prefac-raluca/Proiect-DCE/Aditional/Layout pdf/BOT.pdf

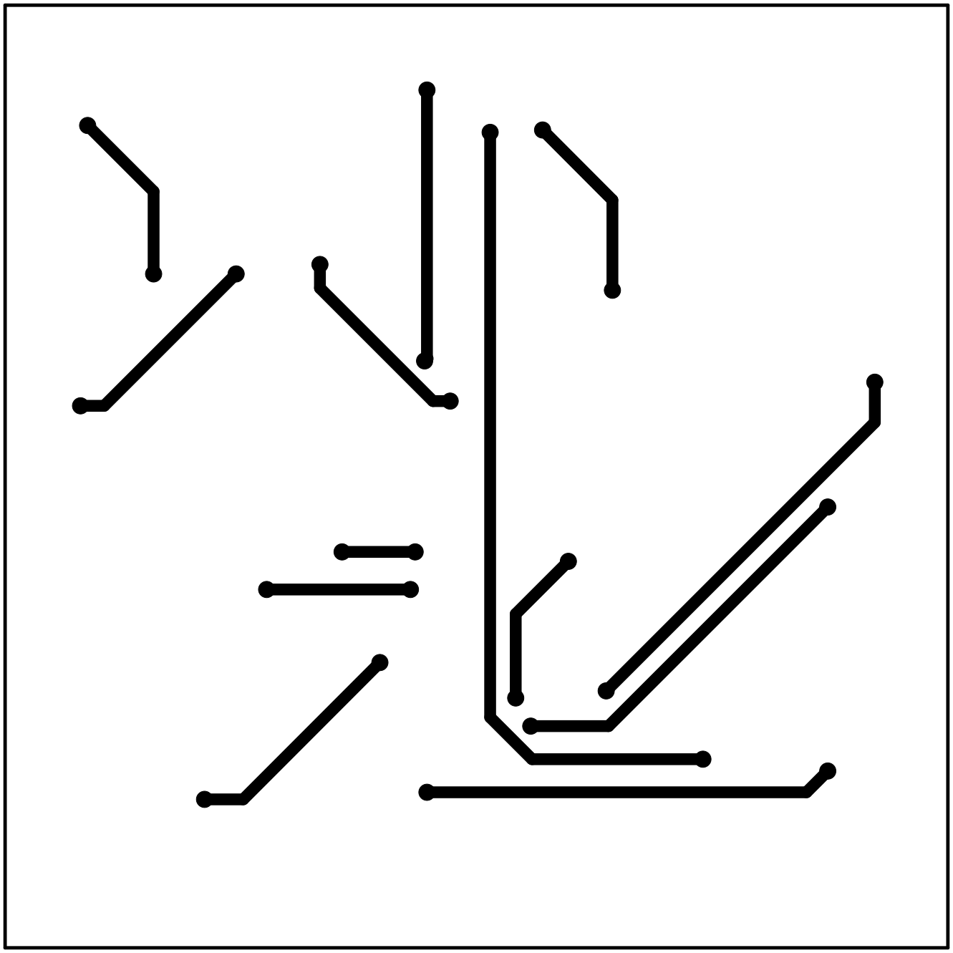
[picture p22: figure]
