prefac-raluca/Proiect-DCE/Aditional/Layout pdf/SMBOT.pdf

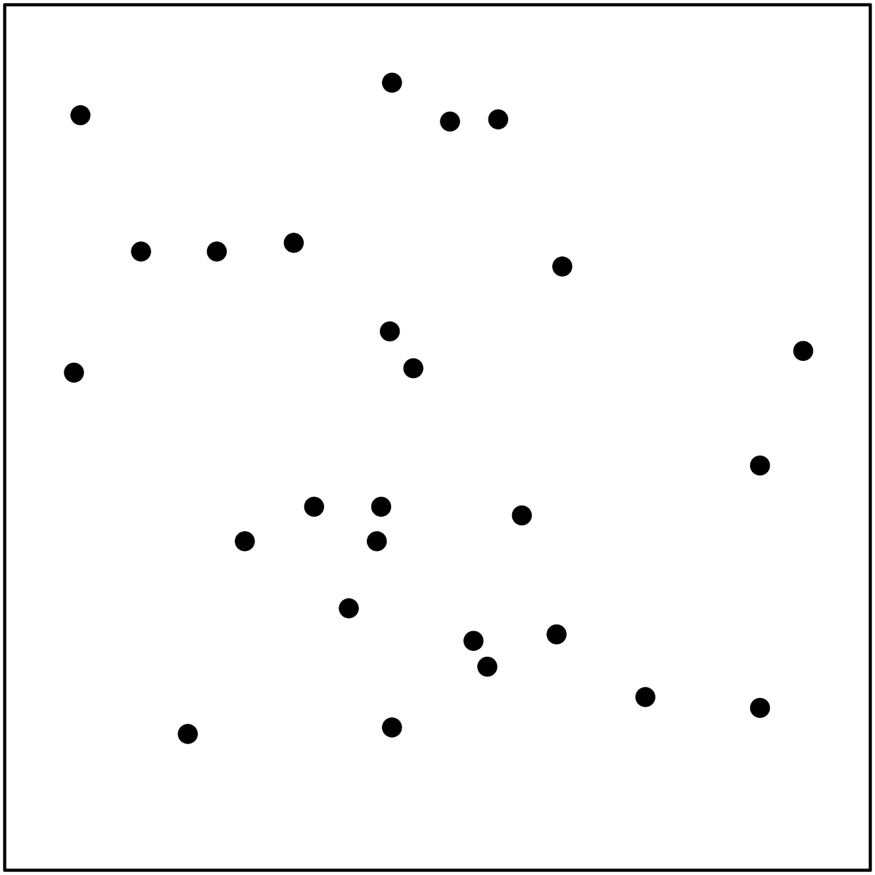
[picture p23: figure]
