prefac-raluca/Proiect-DCE/Aditional/Layout pdf/SMTOP.pdf

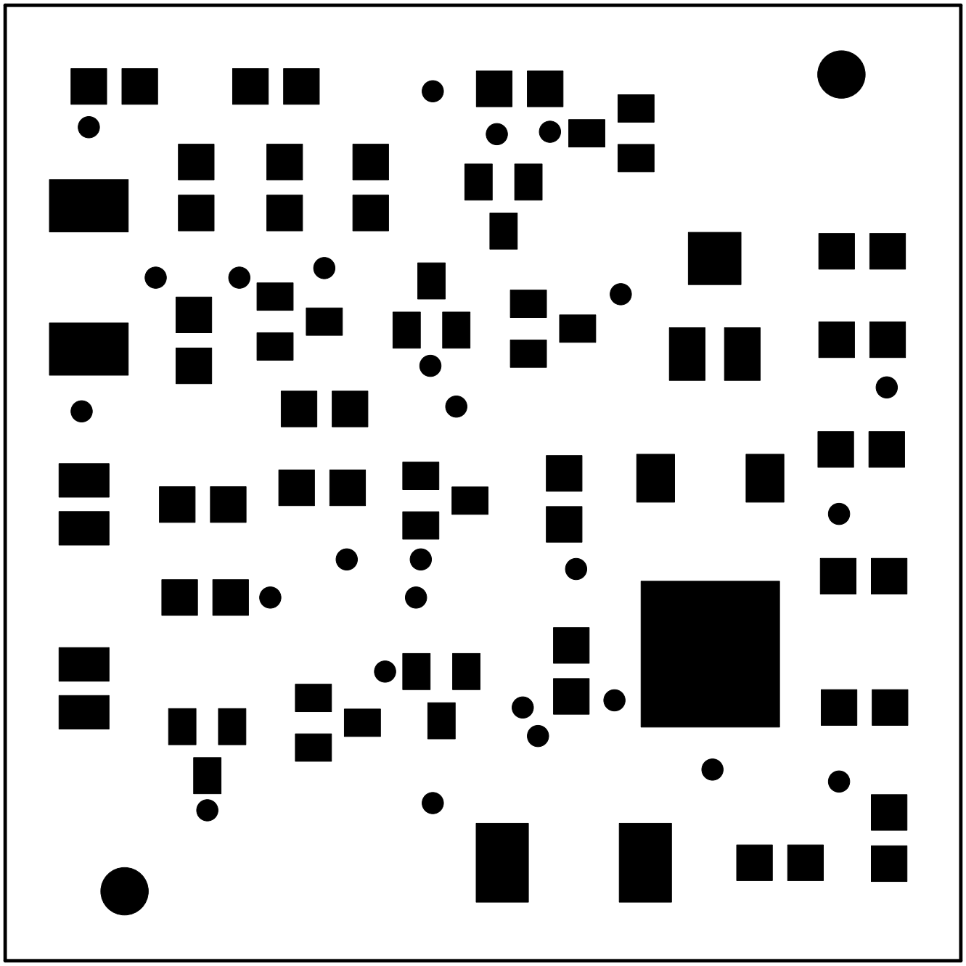
[picture p24: figure]
