prefac-raluca/Proiect-DCE/Aditional/ASAMBLARE/BOM_ASAMBLARE_Prefac Raluca_431C.pdf

Nr. Crt. | Nume | Catalog | Cod distrib | Nume prod | Prod | Clasă | Descriere | ALVEOLA | Nume componentă | Cantitate
1 | 0,47 | (LINK) (http://www.tme.eu/ro/details/smd0805-0r47/rezistente-smd-0805/royal-ohm/0805s8j047kt5e/) | SMD0805-0R47 | 0805S8J047 KT5E | ROYAL OHM | rezistor | Rezistor SMD, chip, 0805, 0.47Ω, ±5%, 0.125W | 1a | R10 | 1
2 | 1 | (LINK) (https://www.tme.eu/ro/details/smd0805-1r/rezistente-smd-0805/royal-ohm/0805s8j010jt5e/) | SMD0805-1R-5% | 0805S8J010 JT5E | ROYAL OHM | rezistor | Rezistor SMD, chip, 0805, 1Ω, ±5%, 0.125W | 1b | R11 | 1
3 | 33 | (LINK) (https://www.tme.eu/ro/details/smd0805-33r/rezistente-smd-0805/royal-ohm/0805s8j0330t5e/) | SMD0805-33R-5% | 0805S8J033 0T5E | ROYAL OHM | rezistor | Rezistor SMD, chip, 0805, 33Ω, ±5%, 0.125W | 3b | R16 | 1
4 | 51 | (LINK) (http://www.tme.eu/ro/details/rc0805jr-0751r/rezistente-smd-0805/yageo/rc0805jr-0751rl/) | SMD0805-51R-5% | 0805S8J051 0T5E | ROYAL OHM | rezistor | Rezistor SMD, chip, 0805, 51Ω, ±5%, 0.125W | 4a | R4, R5, R6 | 3
5 | 100 | (LINK) (https://www.tme.eu/ro/details/smd0805-100r/rezistente-smd-0805/royal-ohm/0805s8j0101t5e/) | SMD0805-100R-5% | 0805S8J010 1T5E | ROYAL OHM | rezistor | Rezistor SMD, chip, 0805, 100Ω, ±5%, 0.125W | 5b | R17 | 1
6 | 150 | (LINK) (https://www.tme.eu/ro/details/smd0805-150r/rezistente-smd-0805/royal-ohm/0805s8j0151t5e/) | SMD0805-150R-5% | 0805S8F150 0T5E | ROYAL OHM | rezistor | Rezistor SMD, chip, 0805, 150Ω, ±5%, 0.125W | 6a | R8,R9,R18,R19 | 4
7 | 510 | (LINK) (https://www.tme.eu/ro/details/smd0805-510r/rezistente-smd-0805/royal-ohm/0805s8j0511t5e/) | SMD0805-510R-5% | 0805S8J051 1T5E | YAGEO | rezistor | Rezistor SMD, chip, 0805, 510Ω, ±5%, 0.125W | 8a | R2, R3, R13 | 3
8 | 1k | (LINK) (https://www.tme.eu/ro/details/smd0805-1k/rezistente-smd-0805/royal-ohm/0805s8j0102t5e/) | SMD0805-1K-5% | 0805S8J010 2T5E | ROYAL OHM | rezistor | Rezistor SMD, chip, 0805, 1kΩ, ±5%, 0.125W | 10a | R7 | 1
9 | 2k | (LINK) (https://www.tme.eu/ro/details/smd0805-2k/rezistente-smd-0805/royal-ohm/0805s8j0202t5e/) | SMD0805-2K-5% | 0805S8J020 2T5E | ROYAL OHM | rezistor | Rezistor SMD, chip, 0805, 2kΩ, ±5%, 0.125W | 11b | R12 | 1
10 | 3.3k | (LINK) (https://www.tme.eu/ro/details/smd0805-3k3/rezistente-smd-0805/royal-ohm/0805s8j0332t5e/) | SMD0805-3K3-5% | 0805S8J033 2T5E | ROYAL OHM | rezistor | Rezistor SMD, chip, 0805, 3.3kΩ, ±5%, 0.125W | 13a | R1, R15 | 2
11 | 2k | (LINK) (https://www.tme.eu/ro/details/ts53yl2k/trimere-smd-cu-o-singura-tura/vishay/ts53yl202mr10/) | TS53YL202 MR10 | TS53YL202 MR10 | VISHAY | potențiometr u | Potențiome-tru liniar, simplă tură, SMD, 2kΩ, ±20%, 100ppm/°C, 0.25W | 25b | R14 | 1

## Anexa a1 - Prefac Raluca - Grupa 431C - Tema SERS

| TOTAL - Componente pasive (rezistoare de valori fixe şi reglabile) | 19
12 | 1uF | (LINK) (https://www.tme.eu/ro/details/cl21b105kbfnnng/condensatoare-mlcc-smd-0805/samsung/) | CL21B105K BFNNNG | CL21B105K BFNNNG | SAMSUNG | condensator | Condensator: ceramic; MLCC; 1uF; 50V; X7R; ±20%; SMD; 0805 | 36a | C1, C2 | 2
| TOTAL - Componente pasive (condensatoare) | | | | | | | | | 2
13 | 4148 | (LINK) (http://www.tme.eu/ro/details/1n4148-0805/diode-universale-smd/dc-components/cd4148ws0805c/) | 1N4148-0805 | CD4148WS( 0805C) | Components DC | diodă pn | Diodă comutație, SMD, 0805, 300mA, 100V | 37b | D2, D3 | 2
14 | 2.7V | (LINK) (https://www.tme.eu/ro/details/bzx84-c2v7.215/diode-zener-smd/nexperia/bzx84-c2v7-215/) | BZX84C2V7 | BZX84-C2V7LT1G | ON Semiconduct or | diodă Zener | Diodă Zener, SMD, SOT23, 2,7V, ±5%, 0.25W | 38b | D1 | 1
15 | PNP | (LINK) (http://www.tme.eu/ro/details/bc856b-dio/tranzistori-smd-pnp/diotec-semiconductor/bc856b/) | BC856B | BC856B | DIOTEC | tranzistor bipolar | Tranzistor bipolar PNP, SMD, SOT23, 80V, 100mA | 41b | Q1, Q2 | 2
16 | NPN | (LINK) (https://www.tme.eu/ro/details/bc846b-dio/tranzistori-smd-npn/diotec-semiconductor/bc846b/) | BC846B | BC846B | DIOTEC | tranzistor bipolar | Tranzistor bipolar NPN, SMD, SOT23, 65V, 100mA | 42a | Q3,Q4,Q5,Q7,Q8,Q9 | 6
17 | NPN | (LINK) (http://www.tme.eu/ro/details/mjd31cg/tranzistori-smd-npn/on-semiconductor/) | MJD31CG | MJD31CG | ON Semiconduct or | tranzistor bipolar | Tranzistor bipolar NPN, SMD, DPACK, 100V, 3A, 15W | 44b | Q6 | 1
| TOTAL - Componente semiconductoare (tranzistoare bipolare şi cu efect de câmp, diode, LED, etc.) | | | | | | | | | 12
| Total general | | | | | | | | | 33
