prefac-raluca/Proiect-DCE/Aditional/ASAMBLARE/Repartizare BOM_2023-2024 1.pdf

Nr. Crt. | Nume | Catalog | Cod distrib | Nume prod | Prod | Clasă | Descriere | Alveola
1 | 0 ohm | (LINK) (http://www.tme.eu/ro/details/smd1206-0r/rezistente-smd-1206/royal-ohm/1206s4j0000t5e/) | 1206S4J000 0T5E | 1206S4J000 0T5E | SR PASSIVES | rezistor | Rezistor: thick film; SMD; 1206; 0Ω; 0,25W; ±5%; -55÷125°C | x
2 | 0.47 | (LINK) (http://www.tme.eu/ro/details/smd0805-0r47/rezistente-smd-0805/royal-ohm/0805s8j047kt5e/) | SMD0805-0R47 | 0805S8J047 KT5E | ROYAL OHM | rezistor | Rezistor SMD, chip, 0805, 0.47Ω, ±5%, 0.125W | 1a
3 | 1 | (LINK) (http://www.tme.eu/ro/details/smd0805-1r-1%25/rezistente-smd-0805/royal-ohm/0805s8f100kt5e/) | SMD0805-1R-1% | 0805S8F100 KT5E | ROYAL OHM | rezistor | Rezistor SMD, chip, 0805, 1Ω, ±1%, 0.125W | 1b
4 | 4.7 | (LINK) (http://www.tme.eu/ro/details/smd0805-4r7-1%25/rezistente-smd-0805/royal-ohm/0805waf-4r7-t5e/) | SMD0805-4R7-1% | 0805WAF 4R7 T5E | ROYAL OHM | rezistor | Rezistor SMD, chip, 0805, 4.7Ω, ±1%, 0.125W | 2a
5 | 10 | (LINK) (http://www.tme.eu/ro/details/smd0805-10r-1%25/rezistente-smd-0805/royal-ohm/0805s8f100jt5e/) | SMD0805-10R-1% | 0805S8F100 JT5E | ROYAL OHM | rezistor | Rezistor SMD, chip, 0805, 10Ω, ±1%, 0.125W | 2b
6 | 22 | (LINK) (http://www.tme.eu/ro/details/smd0805-22r-1%25/rezistente-smd-0805/royal-ohm/0805s8f220jt5e/) | SMD0805-22R-1% | 0805S8F220 JT5E | ROYAL OHM | rezistor | Rezistor SMD, chip, 0805, 22Ω, ±1%, 0.125W | 3a
7 | 33 | (LINK) (http://www.tme.eu/ro/details/smd0805-33r-1%25/rezistente-smd-0805/royal-ohm/0805s8f330jt5e/) | SMD0805-33R-1% | 0805S8F330 JT5E | ROYAL OHM | rezistor | Rezistor SMD, chip, 0805, 33Ω, ±1%, 0.125W | 3b
8 | 51 | (LINK) (http://www.tme.eu/ro/details/rc0805jr-0751r/rezistente-smd-0805/yageo/rc0805jr-0751rl/) | SMD0805-51R-1% | 0805S8F510 JT5E | ROYAL OHM | rezistor | Rezistor SMD, chip, 0805, 51Ω, ±1%, 0.125W | 4a
9 | 68 | (LINK) (http://www.tme.eu/ro/details/smd0805-68r-1%25/rezistente-smd-0805/royal-ohm/0805s8f680jt5e/) | SMD0805-68R-1% | 0805S8F680 JT5E | ROYAL OHM | rezistor | Rezistor SMD, chip, 0805, 68Ω, ±1%, 0.125W | 4b
10 | 82 | (LINK) (http://www.tme.eu/ro/details/smd0805-82r-1%25/rezistente-smd-0805/royal-ohm/0805s8f820jt5e/) | SMD0805-82R-1% | 0805S8F820 JT5E | ROYAL OHM | rezistor | Rezistor SMD, chip, 0805, 82Ω, ±1%, 0.125W | 5a
11 | 100 | (LINK) (http://www.tme.eu/ro/details/smd0805-100r-1%25/rezistente-smd-0805/royal-ohm/0805s8f1000t5e/) | SMD0805-100R-1% | 0805S8F100 0T5E | ROYAL OHM | rezistor | Rezistor SMD, chip, 0805, 100Ω, ±1%, 0.125W | 5b
12 | 150 | (LINK) (http://www.tme.eu/ro/details/smd0805-150r-1%25/rezistente-smd-0805/royal-ohm/0805s8f1500t5e/) | SMD0805-150R-1% | 0805S8F150 0T5E | ROYAL OHM | rezistor | Rezistor SMD, chip, 0805, 150Ω, ±1%, 0.125W | 6a

Anexa 1 - BOM total anul al III-lea - 2018-2019

13 | 220 | (LINK) (http://www.tme.eu/ro/details/smd0805-220r-1%25/rezistente-smd-0805/royal-ohm/0805s8f2200t5e/) | SMD0805-220R-1% | 0805S8F220 0T5E | ROYAL OHM | rezistor | Rezistor SMD, chip, 0805, 220Ω, ±1%, 0.125W | 6b
14 | 330 | (LINK) (http://www.tme.eu/ro/details/smd0805-330r-1%25/rezistente-smd-0805/royal-ohm/0805s8f3300t5e/) | SMD0805-330R-1% | 0805S8F330 0T5E | ROYAL OHM | rezistor | Rezistor SMD, chip, 0805, 330Ω, ±1%, 0.125W | 7a
15 | 470 | (LINK) (http://www.tme.eu/ro/details/smd0805-470r-1%25/rezistente-smd-0805/royal-ohm/0805s8f4700t5e/) | SMD0805-470R-1% | 0805S8F470 0T5E | ROYAL OHM | rezistor | Rezistor SMD, chip, 0805, 470Ω, ±1%, 0.125W | 7b
16 | 510 | (LINK) (http://www.tme.eu/ro/details/smd0805-510r/rezistente-smd-0805/royal-ohm/0805s8j0511t5e/) | SMD0805-510R-5% | 0805S8J051 1T5E | ROYAL OHM | rezistor | Rezistor SMD, chip, 0805, 510Ω, ±5%, 0.125W | 8a
17 | 680 | (LINK) (http://www.tme.eu/ro/details/smd0805-680r-1%25/rezistente-smd-0805/royal-ohm/0805s8f6800t5e/) | SMD0805-680R-1% | 0805S8F680 0T5E | ROYAL OHM | rezistor | Rezistor SMD, chip, 0805, 680Ω, ±1%, 0.125W | 8b
18 | 820 | (LINK) (http://www.tme.eu/ro/details/smd0805-820r-1%25/rezistente-smd-0805/royal-ohm/0805s8f8200t5e/) | SMD0805-820R-1% | 0805S8F820 0T5E | ROYAL OHM | rezistor | Rezistor SMD, chip, 0805, 820Ω, ±1%, 0.125W | 9a
19 | 910 | (LINK) (http://www.tme.eu/ro/details/smd0805-910r/rezistente-smd-0805/royal-ohm/0805waj-910r-t5e/) | SMD0805-910R-5% | 0805WAJ 910R T5E | ROYAL OHM | rezistor | Rezistor SMD, chip, 0805, 910Ω, ±5%, 0.125W | 9b
20 | 1k | (LINK) (http://www.tme.eu/ro/details/smd0805-1k-1%25/rezistente-smd-0805/royal-ohm/0805s8f1001t5e/) | SMD0805-1K-1% | 0805S8F100 1T5E | ROYAL OHM | rezistor | Rezistor SMD, chip, 0805, 1kΩ, ±1%, 0.125W | 10a
21 | 1.5k | (LINK) (http://www.tme.eu/ro/details/smd0805-1k5-1%25/rezistente-smd-0805/royal-ohm/0805s8f1501t5e/) | SMD0805-1K5-1% | 0805S8F150 1T5E | ROYAL OHM | rezistor | Rezistor SMD, chip, 0805, 1.5kΩ, ±1%, 0.125W | 10b
22 | 1.8k | (LINK) (http://www.tme.eu/ro/details/smd0805-1k8-1%25/rezistente-smd-0805/royal-ohm/0805s8f1801t5e/) | SMD0805-1K8-1% | 0805S8F180 1T5E | ROYAL OHM | rezistor | Rezistor SMD, chip, 0805, 1.8kΩ, ±1%, 0.125W | 11a
23 | 2k | (LINK) (http://www.tme.eu/ro/details/smd0805-2k-1%25/rezistente-smd-0805/royal-ohm/0805s8f2001t5e/) | SMD0805-2K-1% | 0805S8F200 1T5E | ROYAL OHM | rezistor | Rezistor SMD, chip, 0805, 2kΩ, ±1%, 0.125W | 11b
24 | 2.2k | (LINK) (http://www.tme.eu/ro/details/smd0805-2k2-1%25/rezistente-smd-0805/royal-ohm/0805s8f2201t5e/) | SMD0805-2K2-1% | 0805S8F220 1T5E | ROYAL OHM | rezistor | Rezistor SMD, chip, 0805, 2.2kΩ, ±1%, 0.125W | 12a
25 | 2.7k | (LINK) (http://www.tme.eu/ro/details/smd0805-2k7-1%25/rezistente-smd-0805/royal-ohm/0805s8f2701t5e/) | SMD0805-2K7-1% | 0805S8F270 1T5E | ROYAL OHM | rezistor | Rezistor SMD, chip, 0805, 2.7kΩ, ±1%, 0.125W | 12b

26 | 3.3k | (LINK) (http://www.tme.eu/ro/details/smd0805-3k3-1%25/rezistente-smd-0805/royal-ohm/0805s8f3301t5e/) | SMD0805-3K3-1% | 0805S8F330 1T5E | ROYAL OHM | rezistor | Rezistor SMD, chip, 0805, 3.3kΩ, ±1%, 0.125W | 13a
27 | 3.9k | (LINK) (http://www.tme.eu/ro/details/smd0805-3k9-1%25/rezistente-smd-0805/royal-ohm/0805s8f3901t5e/) | SMD0805-3K9-1% | 0805S8F390 1T5E | ROYAL OHM | rezistor | Rezistor SMD, chip, 0805, 3.9kΩ, ±1%, 0.125W | 13b
28 | 4.7k | (LINK) (http://www.tme.eu/ro/details/smd0805-4k7-1%25/rezistente-smd-0805/royal-ohm/0805s8f4701t5e/) | SMD0805-4K7-1% | 0805S8F470 1T5E | ROYAL OHM | rezistor | Rezistor SMD, chip, 0805, 4.7kΩ, ±1%, 0.125W | 14a
29 | 5.6k | (LINK) (http://www.tme.eu/ro/details/smd0805-5k6-1%25/rezistente-smd-0805/royal-ohm/0805s8f5601t5e/) | SMD0805-5K6-1% | 0805S8F560 1T5E | ROYAL OHM | rezistor | Rezistor SMD, chip, 0805, 5.6kΩ, ±1%, 0.125W | 14b
30 | 6.8k | (LINK) (http://www.tme.eu/ro/details/smd0805-6k8-1%25/rezistente-smd-0805/royal-ohm/0805s8f6801t5e/) | SMD0805-6K8-1% | 0805S8F680 1T5E | ROYAL OHM | rezistor | Rezistor SMD, chip, 0805, 6.8kΩ, ±1%, 0.125W | 15a
31 | 8.2k | (LINK) (http://www.tme.eu/ro/details/smd0805-8k2-1%25/rezistente-smd-0805/royal-ohm/0805s8f8201t5e/) | SMD0805-8K2-1% | 0805S8F820 1T5E | ROYAL OHM | rezistor | Rezistor SMD, chip, 0805, 8.2kΩ, ±1%, 0.125W | 15b
32 | 9.1k | (LINK) (http://www.tme.eu/ro/details/smd0805-9k1-1%25/rezistente-smd-0805/royal-ohm/0805waf-9k1-t5e/) | SMD0805-9K1-1% | CRCW08051 0K0FKTABC | VISHAY | rezistor | Rezistor SMD, chip, 0805, 9.1kΩ, ±1%, 0.125W | 16a
33 | 10k | (LINK) (http://www.tme.eu/ro/details/crcw080510k0fktabc/rezistente-smd-0805/vishay/) | SMD0805-10K-1% | 0805S8F100 2T5E | ROYAL OHM | rezistor | Rezistor SMD, chip, 0805, 10kΩ, ±1%, 0.125W | 16b
34 | 15k | (LINK) (http://www.tme.eu/ro/details/smd0805-15k-1%25/rezistente-smd-0805/royal-ohm/0805s8f1502t5e/) | SMD0805-15K-1% | 0805S8F150 2T5E | ROYAL OHM | rezistor | Rezistor SMD, chip, 0805, 15kΩ, ±1%, 0.125W | 17a
35 | 22k | (LINK) (http://www.tme.eu/ro/details/smd0805-22k-1%25/rezistente-smd-0805/royal-ohm/0805s8f2202t5e/) | SMD0805-22K-1% | 0805S8F220 2T5E | ROYAL OHM | rezistor | Rezistor SMD, chip, 0805, 22kΩ, ±1%, 0.125W | 17b
36 | 47k | (LINK) (http://www.tme.eu/ro/details/smd0805-47k/rezistente-smd-0805/royal-ohm/0805s8j0473t5e/) | 0805S8J047 3T5E | 0805S8J047 3T5E | ROYAL OHM | rezistor | Rezistor: thick film; SMD; 0805; 47kΩ; 0,125W; ±5%; -55÷125°C | 18a
37 | 68k | (LINK) (http://www.tme.eu/ro/details/rc0805jr-0768k/rezistente-smd-0805/yageo/rc0805jr-0768kl/) | SMD0805-68K-5% | RC0805JR-0768KL | Yageo | rezistor | Rezistor SMD, chip, 0805, 68kΩ, ±5%, 0.125W | 18b

38 | 100k | (LINK) (http://www.tme.eu/ro/details/smd0805-100k-1%25/rezistente-smd-0805/royal-ohm/0805s8f1003t5e/) | SMD0805-100K-1% | 0805S8F100 3T5E | ROYAL OHM | rezistor | Rezistor SMD, chip, 0805, 100kΩ, ±1%, 0.125W | 19a
39 | 150k | (LINK) (http://www.tme.eu/ro/details/smd0805-150k/rezistente-smd-0805/royal-ohm/0805s8j0154t5e/) | SMD0805-150K-5% | 0805S8J015 4T5E | ROYAL OHM | rezistor | Rezistor SMD, chip, 0805, 150kΩ, ±5%, 0.125W | 19b
40 | 180k | (LINK) (http://www.tme.eu/ro/details/smd0805-180k/rezistente-smd-0805/royal-ohm/0805s8j0184t5e/) | SMD0805-180K-5% | 0805S8J018 4T5E | ROYAL OHM | rezistor | Rezistor SMD, chip, 0805, 180kΩ, ±5%, 0.125W | 20a
41 | 220k | (LINK) (http://www.tme.eu/ro/details/smd0805-220k-1%25/rezistente-smd-0805/royal-ohm/0805s8f2203t5e/) | SMD0805-220K-1% | 0805S8F220 3T5E | ROYAL OHM | rezistor | Rezistor SMD, chip, 0805, 220kΩ, ±1%, 0.125W | 20b
42 | 330k | (LINK) (http://www.tme.eu/ro/details/smd0805-330k-1%25/rezistente-smd-0805/royal-ohm/0805s8f3303t5e/) | SMD0805-330K-1% | 0805S8F330 3T5E | ROYAL OHM | rezistor | Rezistor SMD, chip, 0805, 330kΩ, ±1%, 0.125W | 21a
43 | 390k | (LINK) (http://www.tme.eu/ro/details/smd0805-390k-1%25/rezistente-smd-0805/royal-ohm/0805s8f3903t5e/) | SMD0805-390K-1% | 0805S8F390 3T5E | ROYAL OHM | rezistor | Rezistor SMD, chip, 0805, 390kΩ, ±1%, 0.125W | 21b
44 | 510k | (LINK) (http://www.tme.eu/ro/details/smd0805-510k-1%25/rezistente-smd-0805/royal-ohm/0805s8f5103t5e/) | SMD0805-510K-1% | 0805S8F510 3T5E | ROYAL OHM | rezistor | Rezistor SMD, chip, 0805, 510kΩ, ±1%, 0.125W | 22a
45 | 1M | (LINK) (http://www.tme.eu/ro/details/smd0805-1m/rezistente-smd-0805/royal-ohm/0805s8j0105t5e/) | SMD0805-1M | 0805S8J010 5T5E | ROYAL OHM | rezistor | Rezistor SMD, chip, 0805, 1MΩ, ±1%, 0.125W | 22b
46 | 2M | (LINK) (http://www.tme.eu/ro/details/smd0805-2m/rezistente-smd-0805/royal-ohm/0805waj-2m-t5e/) | SMD0805-2M7 | 0805WAJ 2M T5E | ROYAL OHM | rezistor | Rezistor SMD, chip, 0805, 2MΩ, ±1%, 0.125W | 23a
47 | 5M | (LINK) (http://www.tme.eu/ro/details/smd0805-5m1/rezistente-smd-0805/royal-ohm/0805s8j0515t5e/) | SMD0805-5M1 | RC0805FR-075M1 | Yageo | rezistor | Rezistor SMD, chip, 0805, 5.1MΩ, ±1%, 0.125W | 23b
48 | 10M | (LINK) (http://www.tme.eu/ro/details/hp05-10m5%25/rezistente-smd-0805/royal-ohm/hp05w3j0106t5e/) | SMD0805-10M | HP05W3J01 06T5E | ROYAL OHM | rezistor | Rezistor SMD, chip, 0805, 10MΩ, ±5%, 0.125W | 24a

49 | 100ohm | (LINK) (http://www.tme.eu/ro/details/1804gsmd-100r/trimere-smd-cu-o-singura-tura/sr-passives/) | 1804GSMD-100R | 1804GSMD-100R | SR PASSIVES | potențiometr u | Potențiome-tru liniar, simplă tură, SMD, 100Ω, ±10%, 100ppm/°C, 0.25W | 24b
50 | 500ohm | (LINK) (http://www.tme.eu/ro/details/1804gsmd-500r/trimere-smd-cu-o-singura-tura/sr-passives/) | 1804GSMD-500R | 1804GSMD-500R | SR PASSIVES | potențiometr u | Potențiome-tru liniar, simplă tură, SMD, 500Ω, ±10%, 100ppm/°C, 0.25W | 25a
51 | 2k | (LINK) (http://www.tme.eu/ro/details/ts53yl2k/trimere-smd-cu-o-singura-tura/vishay/ts53yl202mr10/) | TS53YL202 MR10 | TS53YL202 MR10 | VISHAY | potențiometr u | Potențiome-tru liniar, simplă tură, SMD, 2kΩ, ±20%, 100ppm/°C, 0.25W | 25b
52 | 5k | (LINK) (http://www.tme.eu/ro/details/3314g-1-502e/trimere-smd-cu-o-singura-tura/bourns/) | 3314G-1-502E | 3314G-1-502E | BOURNS | potențiometr u | Potențiome-tru liniar, simplă tură, SMD, 5kΩ, ±20%, 100ppm/°C, 0.25W | 26a
53 | 10k | (LINK) (http://www.tme.eu/ro/details/3314g-1-103e/trimere-smd-cu-o-singura-tura/bourns/) | 3314G-1-103E | 3314G-1-103E | BOURNS | potențiometr u | Potențiome-tru liniar, simplă tură, SMD, 10kΩ, ±20%, 100ppm/°C, 0.25W | 26b
54 | 50k | (LINK) (http://www.tme.eu/ro/details/3314g-1-503e/trimere-smd-cu-o-singura-tura/bourns/) | 3314G-1-503E | 3314G-1-503E | BOURNS | potențiometr u | Potențiome-tru liniar, simplă tură, SMD, 50kΩ, ±20%, 100ppm/°C, 0.25W | 27a
55 | 100k | (LINK) (http://www.tme.eu/ro/details/ts53yl100k/trimere-smd-cu-o-singura-tura/vishay/ts53yl104mr10/) | TS53YL104 MR10 | TS53YL104 MR10 | VISHAY | potențiometr u | Potențiome-tru liniar, simplă tură, SMD, 100kΩ, ±20%, 100ppm/°C, 0.25W | 27b
56 | 500k | (LINK) (http://www.tme.eu/ro/details/3314g-1-504e/trimere-smd-cu-o-singura-tura/bourns/) | 3314G-1-504E | 3314G-1-504E | BOURNS | potențiometr u | Potențiome-tru liniar, simplă tură, SMD, 500kΩ, ±10%, 100ppm/°C, 0.25W | 28a
57 | 4.7pF | (LINK) (http://www.tme.eu/ro/details/cc0805crnpo94r7/condensatoare-mlcc-smd-0805/yageo/cc0805crnpo9bn4r7/) | CC0805CRN PO9BN4R7 | CC0805CRN PO9BN4R7 | YAGEO | condensator | ceramic; MLCC; 4,7pF; 50V; C0G; ±0,25pF; SMD; 0805 | 28b
58 | 10pF | (LINK) (http://www.tme.eu/ro/details/cc0805jrnpo9100/condensatoare-mlcc-smd-0805/yageo/cc0805jrnpo9bn100/) | CC0805JRN PO9BN100 | CC0805JRN PO9BN100 | YAGEO | condensator | ceramic; MLCC; 10pF; 50V; C0G; ±5%; SMD; 0805 | 29a

59 | 47pF | (LINK) (http://www.tme.eu/ro/details/cl21c470jbannnc/condensatoare-mlcc-smd-0805/samsung/) | CL21C470JB ANNNC | CL21C470JB ANNNC | SAMSUNG | condensator | Condensator : ceramic; MLCC; 47pF; 50V; C0G; ±5%; SMD; 0805; -55÷125°C | 29b
60 | 100pF | (LINK) (http://www.tme.eu/ro/details/cl21c101jbannnc/condensatoare-mlcc-smd-0805/samsung/) | CL21C101JB ANNNC | CL21C101JB ANNNC | SAMSUNG | condensator | Condensator : ceramic; MLCC; 100pF; 50V; C0G; ±5%; SMD; 0805 | 30a
61 | 470pF | (LINK) (http://www.tme.eu/ro/details/cl10b471kb8nnnc/condensatoare-mlcc-smd-0603/samsung/) | CL10B471K B8NNNC | CL10B471K B8NNNC | SAMSUNG | condensator | Condensator : ceramic; MLCC; 470pF; 50V; X7R; ±10%; SMD; 0603 | 30b
62 | 1nF | (LINK) (http://www.tme.eu/ro/details/c0805c102j5gac/condensatoare-mlcc-smd-0805/kemet/) | C0805C102J 5GAC | C0805C102J 5GAC | KEMET | condensator | Condensator MLCC, SMD, 0805, 1nF, ±5%, 50V, C0G | 31a
63 | 2.2nF | (LINK) (http://www.tme.eu/ro/details/cl21b222kbannnd/condensatoare-mlcc-smd-0805/samsung/) | CL21B222K BANNND | CL21B222K BANNND | SAMSUNG | condensator | Condensator : ceramic; MLCC; 2,2nF; 50V; X7R; ±10%; SMD; 0805 | 31b
64 | 4.7nF | (LINK) (http://www.tme.eu/ro/details/c0805c472k5rac/condensatoare-mlcc-smd-0805/kemet/) | C0805C472 K5RAC | C0805C472 K5RAC | KEMET | condensator | Condensator MLCC, SMD, 0805, 4.7nF, ±5%, 50V, X7R | 32a
65 | 5.6nF | (LINK) (http://www.tme.eu/ro/details/cl21b562kbannnc/condensatoare-mlcc-smd-0805/samsung/) | CL21B562K BANNNC | CL21B562K BANNNC | SAMSUNG | condensator | Condensator MLCC, SMD, 0805, 5.6nF, ±5%, 50V, X7R | 32b
66 | 10nF | (LINK) (http://www.tme.eu/ro/details/cl21b103kcannnc/condensatoare-mlcc-smd-0805/samsung/) | CL21B103K CANNNC | CL21B103K CANNNC | SAMSUNG | condensator | Condensator MLCC, SMD, 0805, 10nF, ±5%, 50V, X7R | 33a
67 | 22nF | (LINK) (http://www.tme.eu/ro/details/cl21b223kcfnnne/condensatoare-mlcc-smd-0805/samsung/) | CL21B223K CFNNNE | CL21B223K CFNNNE | SAMSUNG | condensator | Condensator : ceramic; MLCC; 22nF; 100V; X7R; ±10%; SMD; 0805 | 33b
68 | 33nF | (LINK) (http://www.tme.eu/ro/details/cl21b333kbannnc/condensatoare-mlcc-smd-0805/samsung/) | CL21B333K BANNNC | CL21B333K BANNNC | SAMSUNG | condensator | Condensator : ceramic; MLCC; 33nF; 50V; X7R; ±10%; SMD; 0805 | 34a
69 | 100nF | (LINK) (http://www.tme.eu/ro/details/cc0805krx7r9104/condensatoare-mlcc-smd-0805/yageo/cc0805krx7r9bb104/) | CC0805KRX 7R9BB104 | CC0805KRX 7R9BB104 | YAGEO | condensator | ceramic; MLCC; 100nF; 50V; X7R; ±10%; SMD; 0805 | 34b

70 | 220nF | (LINK) (http://www.tme.eu/ro/details/cl21b224kafnnne/condensatoare-mlcc-smd-0805/samsung/) | CL21B224K AFNNNE | CL21B224K AFNNNE | SAMSUNG | condensator | Condensator : ceramic; MLCC; 220nF; 25V; X7R; ±10%; SMD; 0805 | 35a
71 | 330nF | (LINK) (http://www.tme.eu/ro/details/08055c334kat2a/condensatoare-mlcc-smd-0805/avx/) | 08055C334K AT2A | 08055C334K AT2A | AVX | condensator | Condensator : ceramic; MLCC; 330nF; 50V; X7R; ±10%; SMD; 0805 | x
72 | 470nF | (LINK) (http://www.tme.eu/ro/details/cl21b474kbfnnng/condensatoare-mlcc-smd-0805/samsung/) | CL21B474K BFNNNG | CL21B474K BFNNNG | SAMSUNG | condensator | Condensator : ceramic; MLCC; 470nF; 50V; Y5V; -20÷+80%; SMD; 0805 | 35b
73 | 1uF | (LINK) (http://www.tme.eu/ro/details/cc0805kkx7r8105/condensatoare-mlcc-smd-0805/yageo/cc0805kkx7r8bb105/) | CC0805KKX 7R8BB105 | CC0805KKX 7R8BB105 | YAGEO | condensator | Condensator : ceramic; MLCC; 1uF; 25V; X7R; ±10%; SMD; 0805 | 36a
74 | 2.2uF | (LINK) (http://www.tme.eu/ro/details/grm219r61e225ka12d/condensatoare-mlcc-smd-0805/murata/) | GRM219R61 E225KA12D | GRM219R61 E225KA12D | MURATA | condensator | Condensator : ceramic; MLCC; 2,2uF; 25V; X5R; ±10%; SMD; 0805 | 36b
75 | 4.7uF | (LINK) (http://www.tme.eu/ro/details/cl21a475kaqnnne/condensatoare-mlcc-smd-0805/samsung/) | CL21A475K AQNNNE | CL21A475K AQNNNE | SAMSUNG | condensator | ceramic; MLCC; 4,7uF; 25V; X5R; ±10%; SMD; 0805 | 37a
76 | 10uF | (LINK) (http://www.tme.eu/ro/details/eeefk1j100p/condensatoare-electrol-smd-imped-joasa/panasonic/) | SC1H106M0 5005VR | SC1H106M0 5005VR | SAMWHA | condensator | Condensator : electrolitic; cu impedanţă redusă; SMD; 10uF; 63V | x
| TOTAL - Componente pasive (condensatoare)
77 | 4148 | (LINK) (http://www.tme.eu/ro/details/1n4148-0805/diode-universale-smd/dc-components/cd4148ws0805c/) | 1N4148-0805 | CD4148WS( 0805C) | DC Components | diodă pn | Diodă comutație, SMD, 0805, 300mA, 100V | 37b
78 | LED | (LINK) (http://www.tme.eu/ro/details/kp-2012src-prv/led-uri-smd-0805/kingbright-electronic/) | KP-2012SRC-PRV | KP-2012SRC-PRV | Kingbright Electronic | LED | LED roșu, SMD, 0805, 100mcd, 640nm, 120° | 38a
79 | 2.7V | (LINK) (http://www.tme.eu/ro/details/bzx84c2v7/diode-zener-smd/on-semiconductor/bzx84c2v7lt1g/) | BZX84C2V7 | BZX84-C2V7LT1G | ON Semiconduct or | diodă Zener | Diodă Zener, SMD, SOT23, 2,7V, ±5%, 0.25W | 38b
80 | 5.1V | (LINK) (http://www.tme.eu/ro/details/bzx84c5v1/diode-zener-smd/nxp/bzx84-c5v1215/) | BZX84C5V1 | BZX84-C5V1 | NXP | diodă Zener | Diodă Zener, SMD, SOT23, 5,1V, ±5%, 0.3W | 39a

81 | 5.6V | (LINK) (http://www.tme.eu/ro/details/bzx84c5v6/diode-zener-smd/nxp/bzx84-c5v6215/) | BZX84C5V6 | BZX84-C5V6 | NXP | diodă Zener | Diodă Zener, SMD, SOT23, 5,6V, ±5%, 0.3W | 39b
82 | 6.2V | (LINK) (http://www.tme.eu/ro/details/bzx84c6v2/diode-zener-smd/nxp/bzx84-c6v2215/) | BZX84C6V2 | BZX84-C6V2 | NXP | diodă Zener | Diodă Zener, SMD, SOT23, 6.2V, ±5%, 0.3W | 40a
83 | 6.8V | (LINK) (http://www.tme.eu/ro/details/bzx84c6v8/diode-zener-smd/nxp/bzx84-c6v8215/) | BZX84C6V8 | BZX84-C6V8 | NXP | diodă Zener | Diodă Zener, SMD, SOT23, 6.8V, ±5%, 0.3W | x
84 | 8.2V | (LINK) (http://www.tme.eu/ro/details/bzx84c8v2/diode-zener-smd/nxp/bzx84-c8v2215/) | BZX84C8V2 | BZX84-C8V2 | NXP | diodă Zener | Diodă Zener, SMD, SOT23, 8.2V, ±5%, 0.3W | 40b
85 | 10V | (LINK) (http://www.tme.eu/ro/details/bzx84c10/diode-zener-smd/nxp/bzx84-c10215/) | BZX84C10 | BZX84-C10 | NXP | diodă Zener | Diodă Zener, SMD, SOT23, 10V, ±5%, 0.3W | 41a
86 | PNP | (LINK) (http://www.tme.eu/ro/details/bc856b-dio/tranzistori-smd-pnp/diotec-semiconductor/bc856b/) | BC856B | BC856B | DIOTEC | tranzistor bipolar | Tranzistor bipolar PNP, SMD, SOT23, 80V, 100mA | 41b
87 | NPN | (LINK) (http://www.tme.eu/ro/details/bc846b.215/tranzistori-smd-npn/nxp/) | BC846B | BC846B | NXP | tranzistor bipolar | Tranzistor bipolar NPN, SMD, SOT23, 65V, 100mA | 42a
89 | N-JFET | (LINK) (http://www.tme.eu/ro/details/mmbfj309lt1g/tranzistori-canal-n-smd/on-semiconductor/) | MMBFJ309L T1G | MMBFJ309L T1G | ON Semiconduct or | tranzistor NJFET | Tranzistor N-JFET, SMD, SOT23, 25V, 30mA | 42b
90 | P-JFET | (LINK) (http://www.tme.eu/ro/details/mmbfj177lt1g/tranzistori-canal-p-smd/on-semiconductor/) | MMBFJ177L T1G | MMBFJ177L T1G | ON Semiconduct or | tranzistor PJFET | Tranzistor P-JFET, SMD, SOT23, 30V, 20mA | 43a
91 | NPN | (LINK) (http://www.tme.eu/ro/details/bc817-25-dio/tranzistori-smd-npn/diotec-semiconductor/bc817-25/) | BC817-25-DIO | BC817-25-DIO | NXP | tranzistor bipolar | Tranzistor bipolar NPN, SMD, SOT23, 45V, 800mA | 43b
93 | PNP | (LINK) (http://www.tme.eu/ro/details/bc807-25-dio/tranzistori-smd-pnp/diotec-semiconductor/bc807-25/) | BC807-25-DIO | BC807-25-DIO | NXP | tranzistor bipolar | Tranzistor bipolar PNP, SMD, SOT23, 45V, 800mA | 44a
94 | NPN | (LINK) (http://www.tme.eu/ro/details/mjd31cg/tranzistori-smd-npn/on-semiconductor/) | MJD31CG | MJD31CG | ON Semiconduct or | tranzistor bipolar | Tranzistor bipolar NPN, SMD, DPACK, 100V, 3A, 15W | 44b

96 | PNP | (LINK) (http://www.tme.eu/ro/details/mjd32cg/tranzistori-smd-pnp/on-semiconductor/) | MJD32CG | MJD32CG | ON Semiconduct or | tranzistor bipolar | Tranzistor bipolar PNP, SMD, DPACK, 100V, 3A, 15W | 45a
97 | Nmos | (LINK) (http://www.tme.eu/ro/details/irfr120npbf/tranzistori-canal-n-smd/international-rectifier/) | IRFR120NP BF | IRFR120NP BF | International Rectifier | tranzistor NMOS | Tranzistor N-MOSFET, SMD, DPAK, 100V, 9.1A, 20V, 39W | 45b
| TOTAL - Componente semiconductoare (tranzistoare bipolare şi cu efect de câmp, diode, LED, etc.)
98 | Conn2p | (LINK) (http://www.tme.eu/ro/details/zl301-40p/pini-cu-benzi-si-soclu/ninigi/) | ZL301-40P | ZL301-40P | NINIGI | Sir pini, pas 2,54mm, SMD | Sir pini, pas 2,54mm, SMD, tip tata, bareta de 40 pini | x
99 | FUSE | (LINK) (http://www.tme.eu/ro/details/3413.0116.11/sigurante-smd-1206-ultrarapide/schurter/) | 3413.0116.1 1 | 3413.0116.1 1 | SCHURTER | sigu-ranță | Siguranță sticlă, SMD, 1206, 1.25A, 48mΩ | x
| Total - Conectică, sigurante fuzibile, etc.
| Total general
