prefac-raluca/Proiect-DCE/Proiect_Schematic.pdf

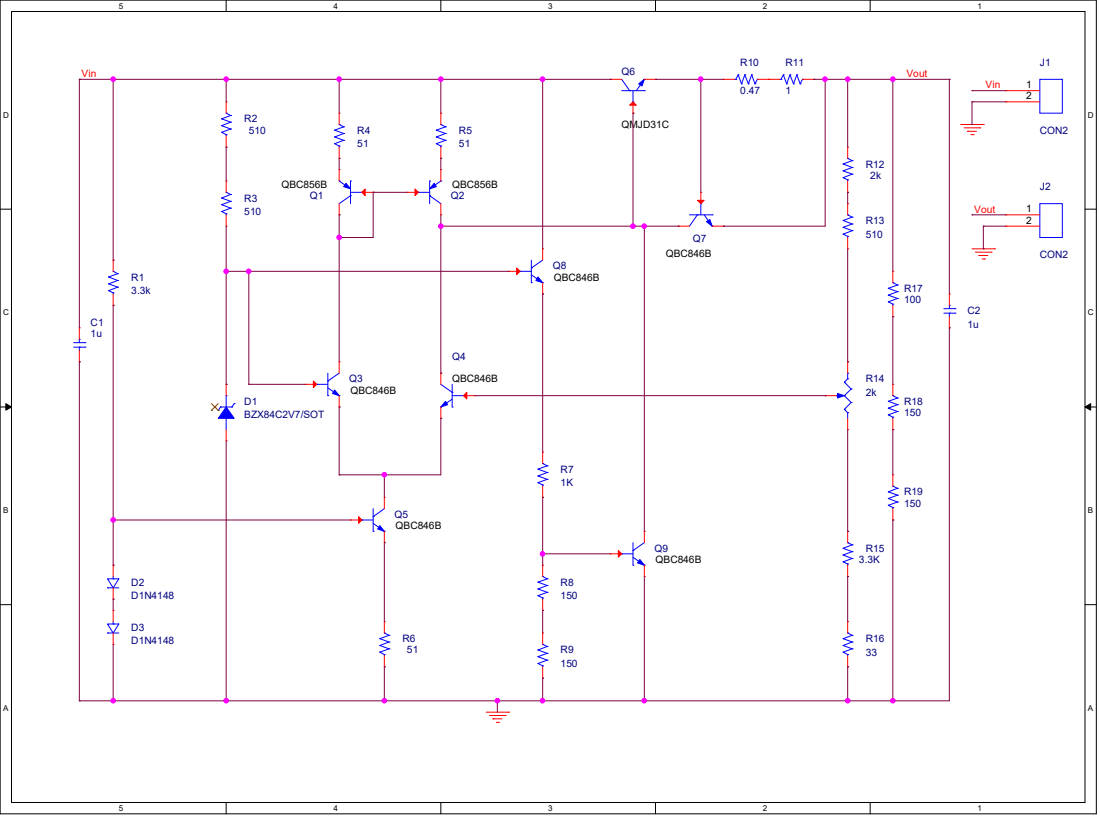
[picture p25: page 1]
