prefac-raluca/Proiect-DCE/Aditional/ASAMBLARE/ALL.pdf

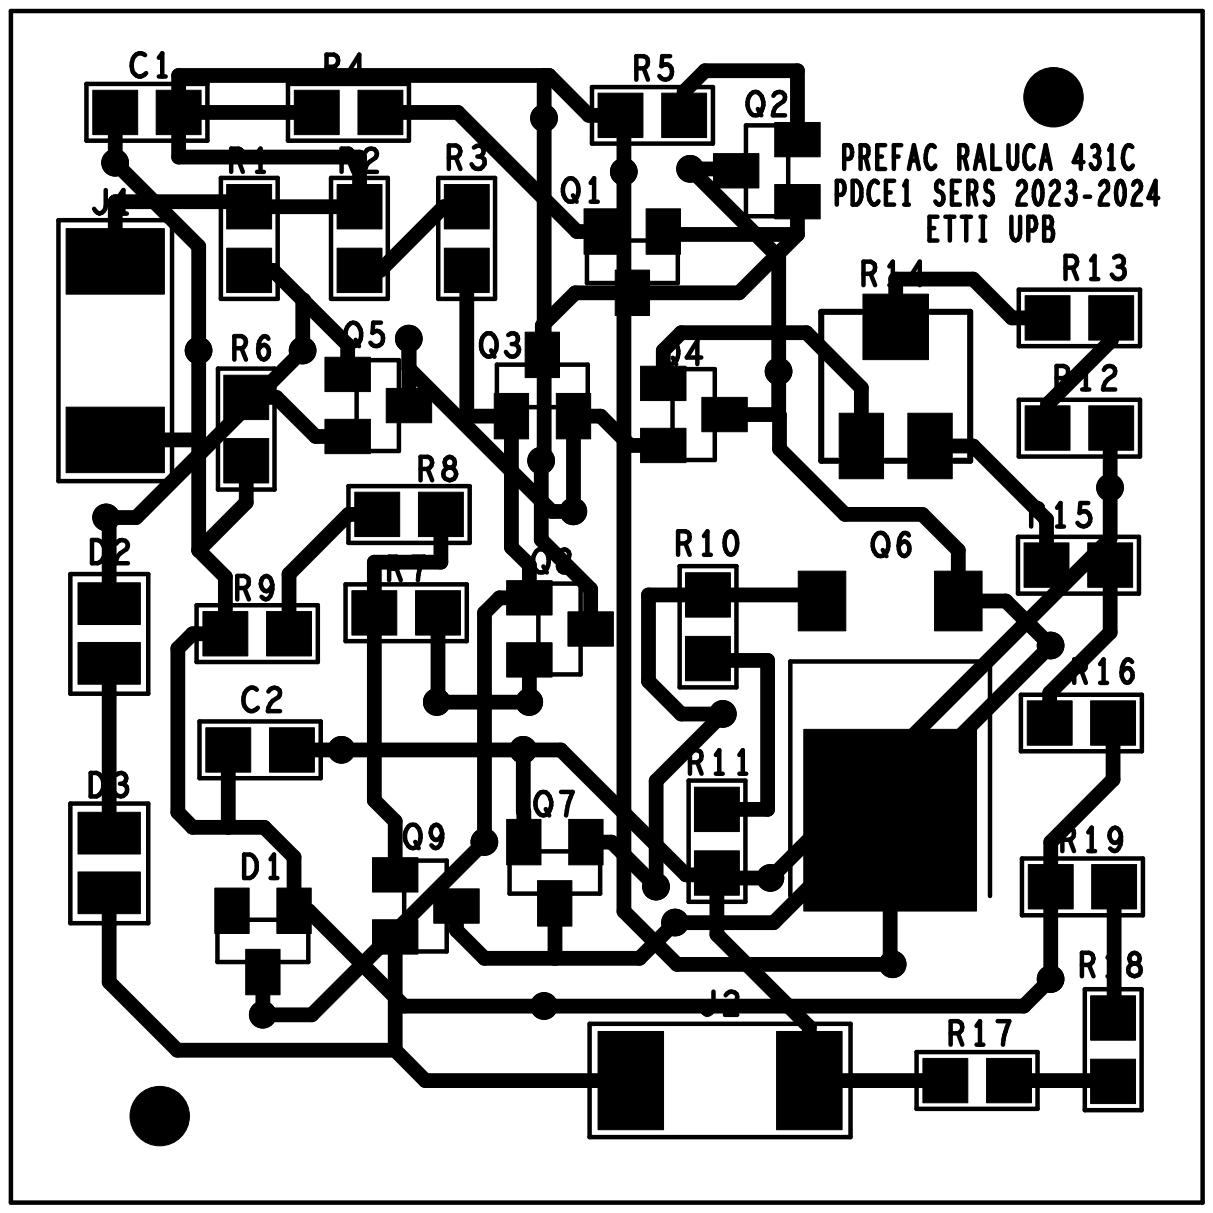
[picture p26: page 1]
