prefac-raluca/Proiect-DCE/Aditional/ASAMBLARE/ALL_PCB.pdf

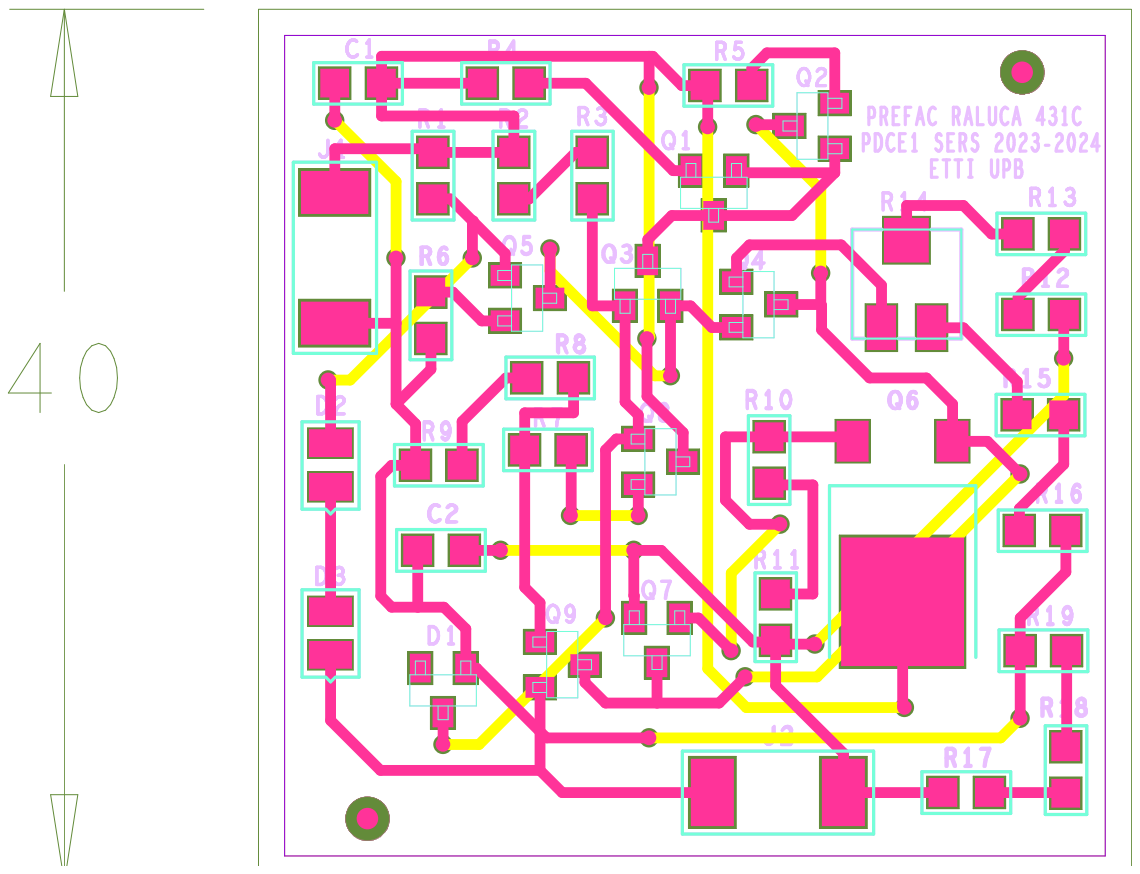
[picture p27: page 1]
