prefac-raluca/Proiect-DCE/Aditional/ASAMBLARE/TOP all.pdf

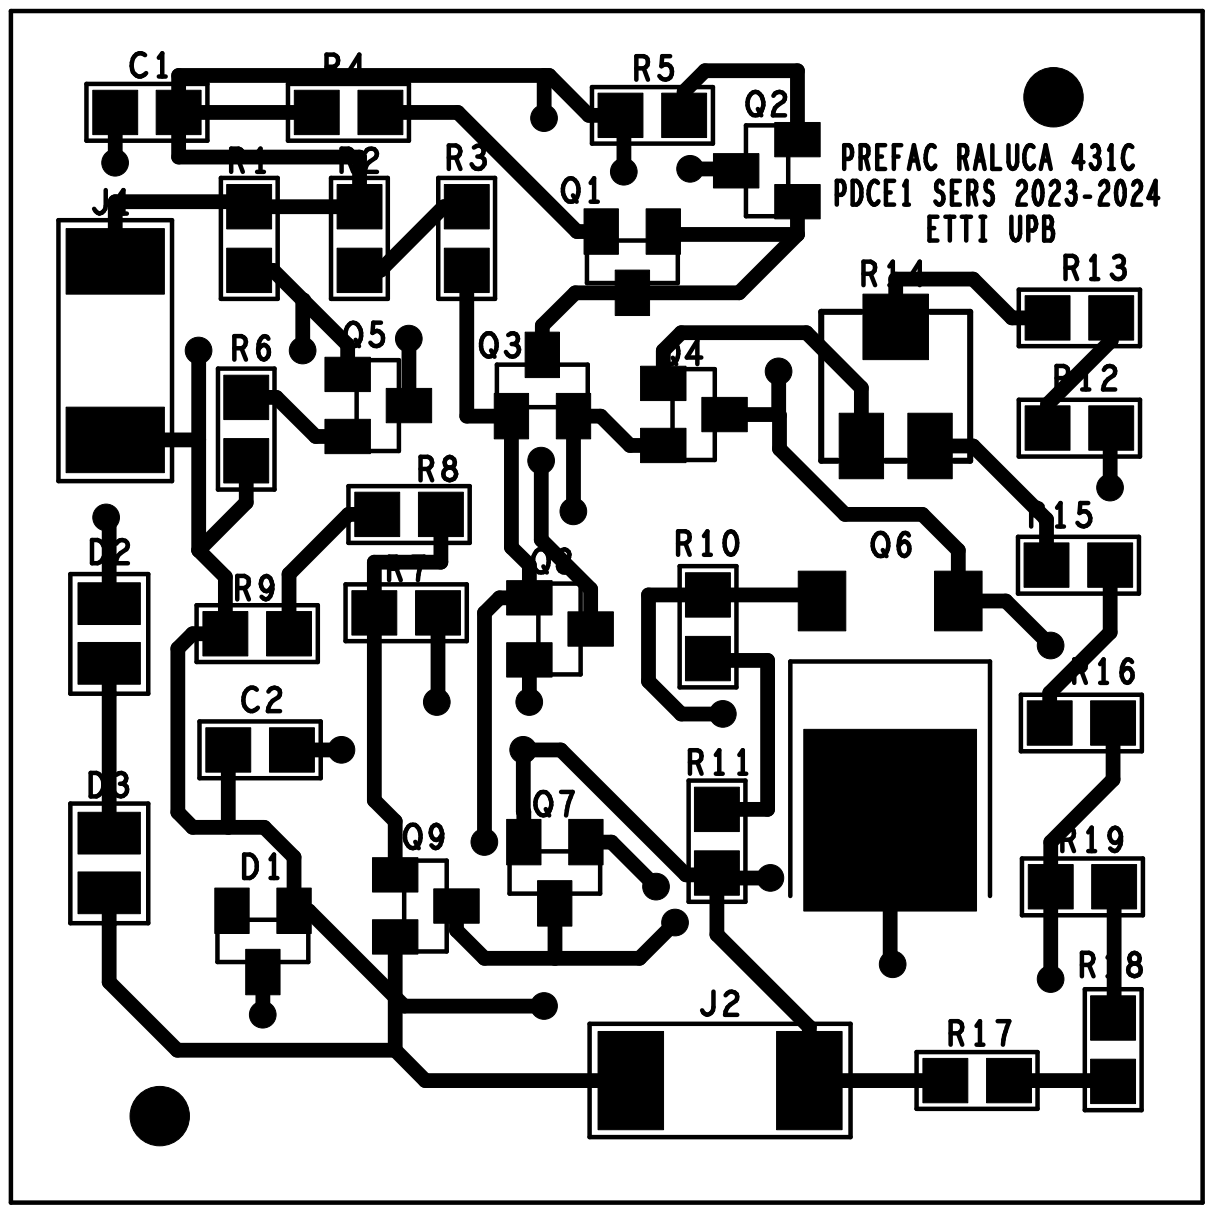
[picture p28: page 1]
