prefac-raluca/Proiect-DCE/Aditional/Layout pdf/FAB.pdf

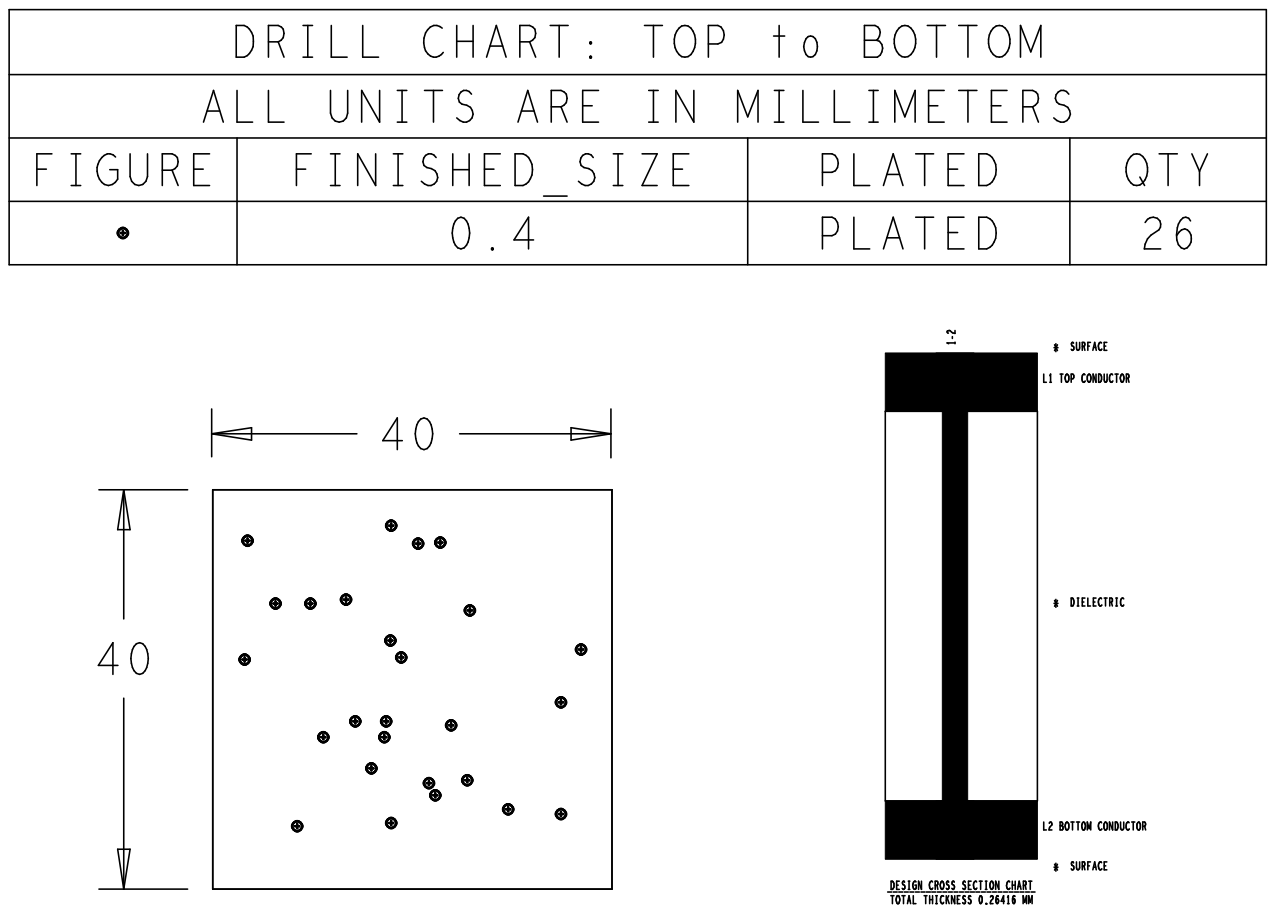
[picture p29: page 1]
