prefac-raluca/Proiect-DCE/Aditional/Layout pdf/SSTOP.pdf

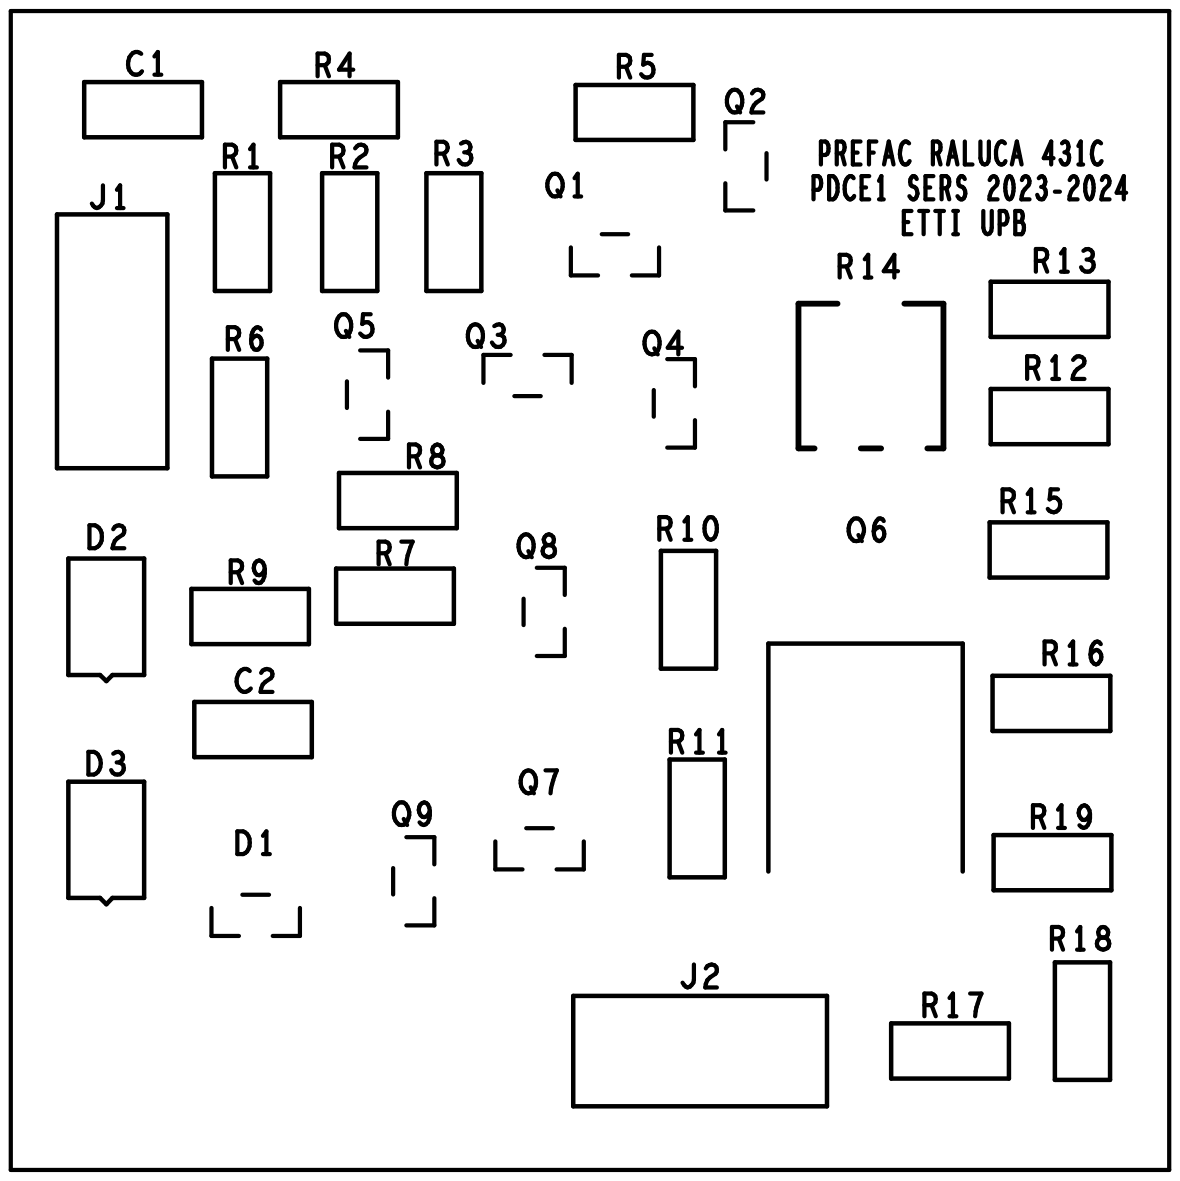
[picture p30: page 1]
