prefac-raluca/Proiect-DCE/Aditional/Layout pdf/TOP.pdf

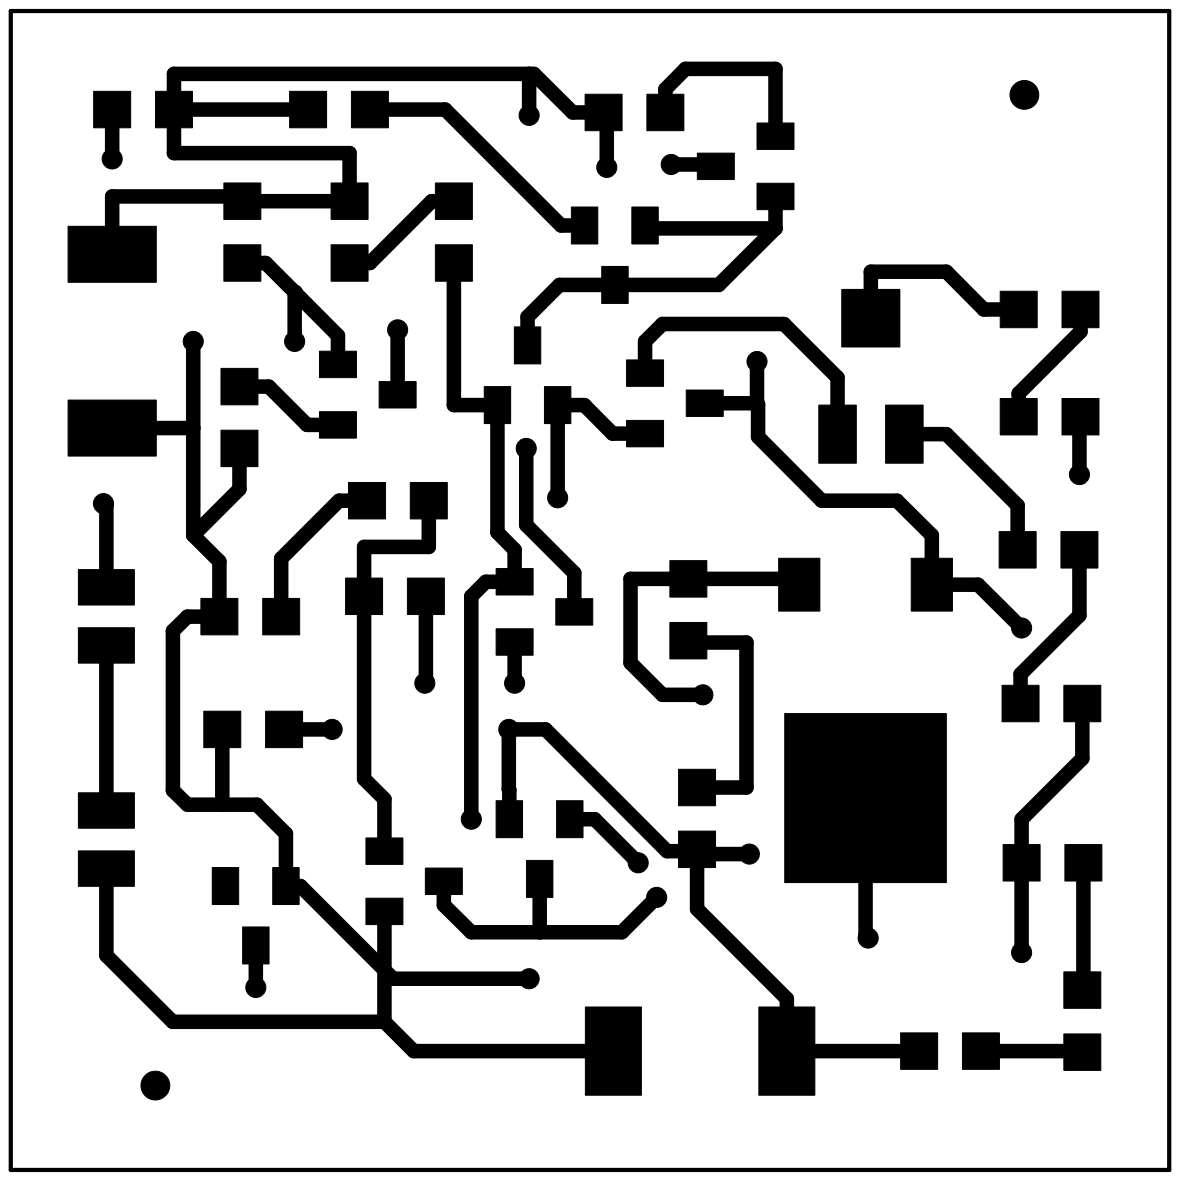
[picture p31: page 1]
