prefac-raluca/Proiect-DCE/(list of files, drawings)

Other design files:
P1_SERS_Prefac Raluca_431C.opj
